MCbx/ictester-standalone/technical/testing_pcb.jpg

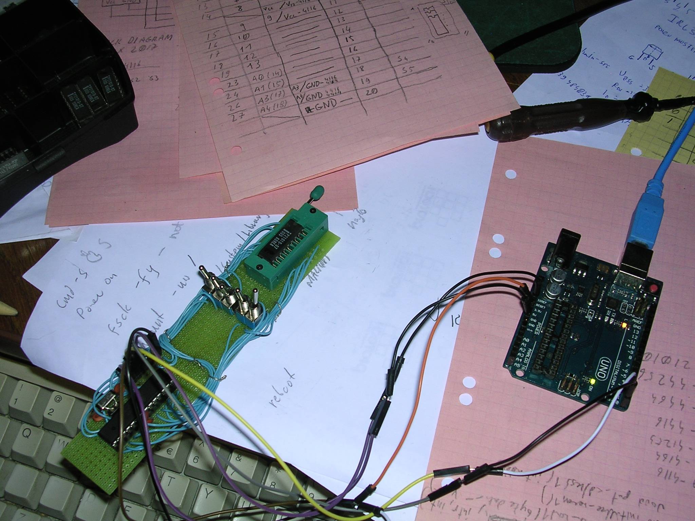
technical/testing_pcb.jpg
