MCbx/ictester-standalone/technical/prototype.jpg

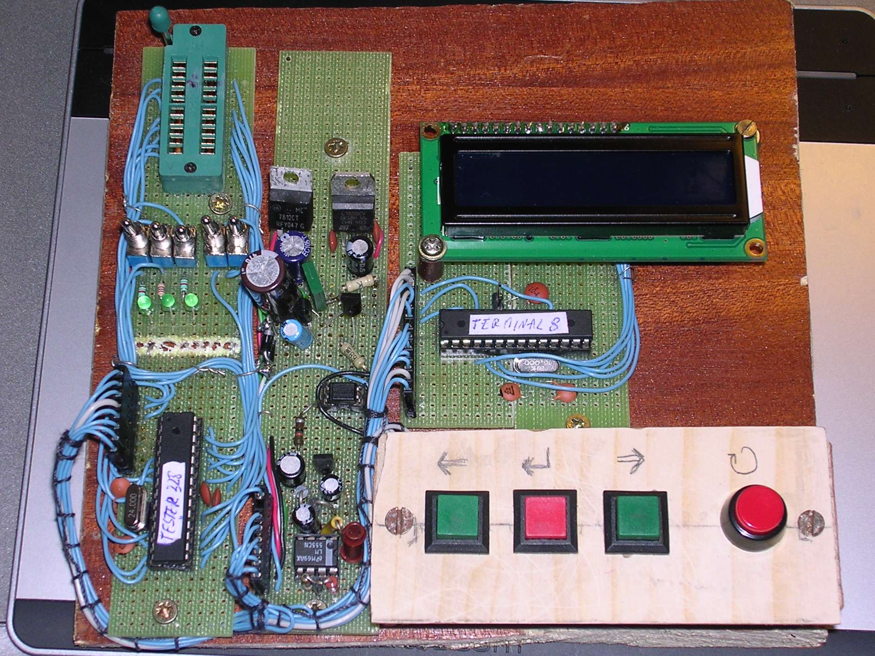
technical/prototype.jpg
