MCbx/ictester-standalone/technical/01_power_supply.jpg

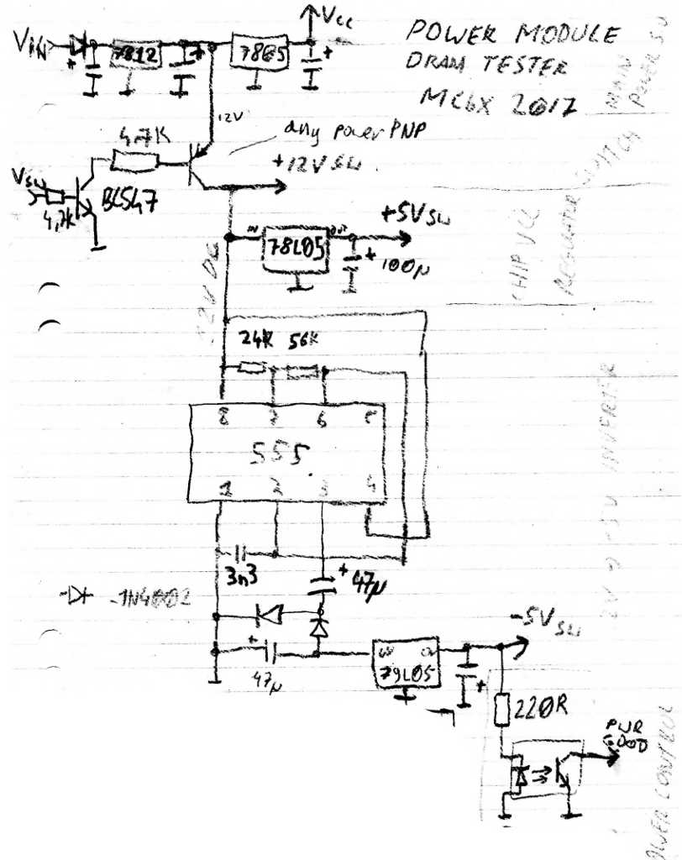
technical/01_power_supply.jpg
