MCbx/ictester-standalone/technical/03_dram_pins.jpg

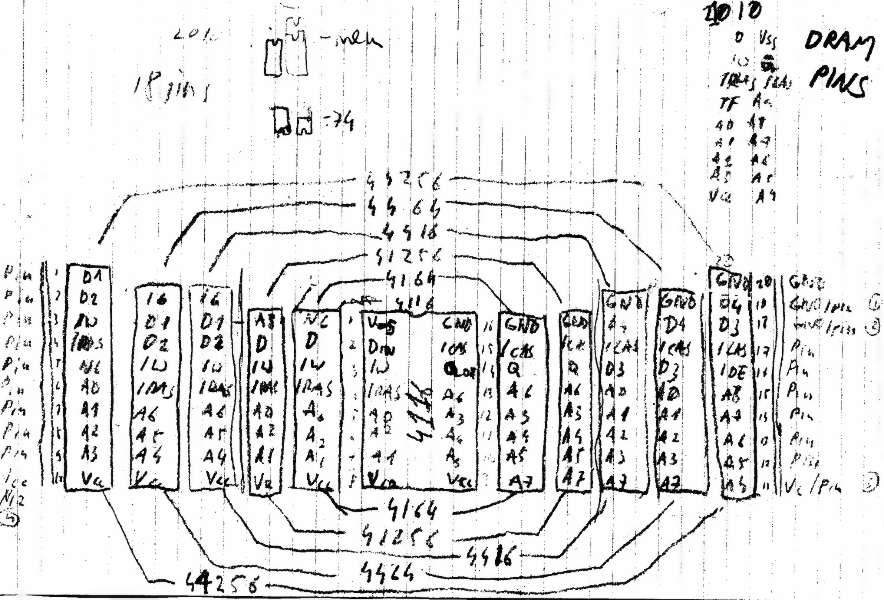
technical/03_dram_pins.jpg
