MCbx/ictester-standalone/technical/04_ttltest_chip_pins_vs_script_bits.jpg

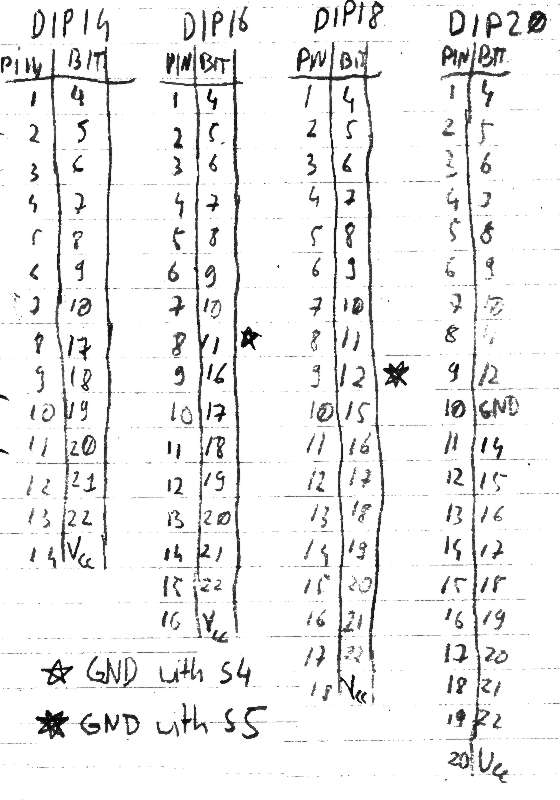
technical/04_ttltest_chip_pins_vs_script_bits.jpg
