MCbx/ictester-standalone/technical/prototype_modules_wiring.jpg

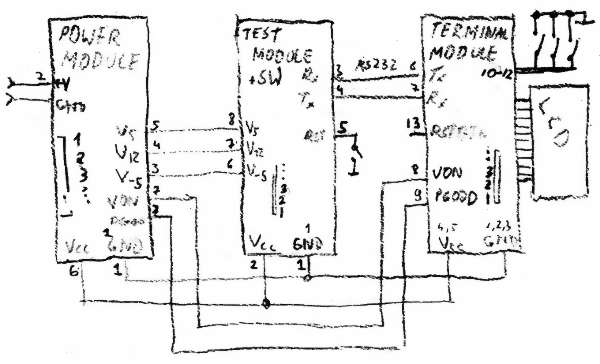
technical/prototype_modules_wiring.jpg
