MCbx/ictester-standalone/technical/02_tester_pins.jpg

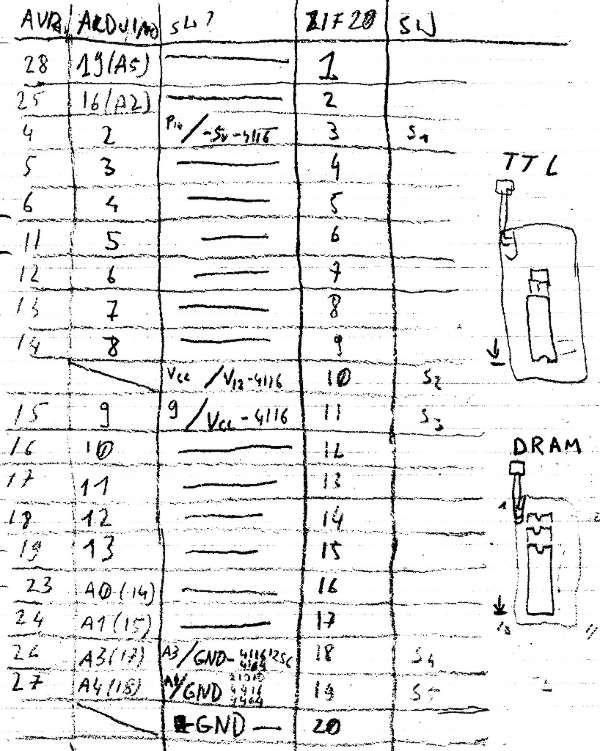
technical/02_tester_pins.jpg
