MCbx/ictester-standalone/main_tester/logic_test.ino

//TTL 74 tester
//EXPERIMENTAL
//MCbx 2017

//Please update me after writing script!
const PROGMEM unsigned long chips1[]={7400, 74000, 7401, 7402, 7403, 74040506, 7407, 740809, 7410, 7411, 7412, 7413, 7414, 7415, 7416, 
                                       7417, 7418, 7419, 7420, 7421, 7422, 7427, 7430, 7432, 7438, 7442, 7445, 7450, 7451, 7474,
                                       7485, 7486, 7495, 74125,74126,74132,74138,74139,74145,74147,74151,74153,74156,74161,74164,
                                       74165,74174,74175,74193,74240,74243,74244,74245,74251,74253,74257,74273,74299,74365,74373,
                                       74374,74393,74541,74027,8216, 8286, 74405,4011, 4012, 4013, 4015, 4016, 4024, 4027, 4040,
                                       4066, 4093, 40106};
#define chips1count 77   //me too!
 
//WRITING TEST SCRIPTS
//1. General order is the order of chips1.
//2. Script is array of longs. One long, one command. First 24 bits are used.
//3. First (0th) long is length of script with this number (eg. {3,22,33})
//4. Commands are following:
//  - 1xy - x - monitor for SW4, y - monitor for SW5 up. 3 for SW4, 5 for SW5, 7 for both
//  - 0000z - set i/o. 1 is input TO TESTER.
//  - 0001z - send states to ic
//  - 0011z - verify inputs against states
//  where z is always 20 bits of data. Rest is meaningless.
//5. After writing script, update const long* const script[] PROGMEM. Is must be this way or RAM will fill up.
// I'm giving a conv2script.pl Perl program to convert ICTester's MOD file to these numbers.

const long s001[] PROGMEM = {10,1180224, 8, 1180236, 4718888, 5899116, 2359448, 3539676, 7078328, 7078332};
const long s002[] PROGMEM = {12, 786944, 8, 786956, 1179720, 1179724, 2097288, 2359436, 4325640, 4325644, 7471560, 7471564};
const long s003[] PROGMEM = {10, 4718736, 8, 4718748, 2359880, 7078620, 1179944, 5898684, 3539816, 3539820};
const long s004[] PROGMEM = {10, 4718736, 8, 4718748, 1179944, 1179948, 2359880, 2359884, 3539816, 3539820};
const long s005[] PROGMEM = {10, 1180224, 8, 1180236, 4718888, 5899116, 2359448, 3539676, 7078328, 7078332};
const long s006[] PROGMEM = {6, 2753184, 8, 2753196, 5505368, 5505372};
const long s007[] PROGMEM = {6, 2753184, 8, 12, 5505368, 8258556};
const long s008[] PROGMEM = {10, 1180224, 8, 12, 5767528, 4718892, 2359448, 2359452, 7078328, 8258556};
const long s009[] PROGMEM = {18, 2228736, 8, 2228748, 262232, 2490972, 524456, 2753196, 786680, 3015420, 5243144, 7471884, 5505368, 7734108, 5767592, 7996332, 6029816, 6029820};
const long s010[] PROGMEM = {18, 2228736, 8, 12, 262232, 262236, 524456, 524460, 786680, 786684, 5243144, 5243148, 5505368, 5505372, 5767592, 5767596, 6029816, 8258556};
const long s011[] PROGMEM = {18, 2228736, 8, 2228748, 262232, 2490972, 524456, 2753196, 786680, 3015420, 5243144, 7471884, 5505368, 7734108, 5767592, 7996332, 6029816, 6029820};
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
const long s077[] PROGMEM = {10, 1573056, 8, 1573068, 2228504, 3801564, 4457000, 6030060, 6685496, 6685500};
const long s078[] PROGMEM = {6, 2753184, 8, 2753196, 8258552, 5505372};
//const long s061[] PROGMEM = {};

const long* const script[] PROGMEM = { s001, s002, s003, s004, s005, s006, s007, s008, s009, s010, s011, s012, s013, s014, s015,
                                       s016, s017, s018, s019, s020, s021, s022, s023, s024, s025, s026, s027, s028, s029, s030,
                                       s031, s032, s033, s034, s035, s036, s037, s038, s039, s040, s041, s042, s043, s044, s045,
                                       s046, s047, s048, s049, s050, s051, s052, s053, s054, s055, s056, s057, s058, s059, s060, 
                                       s061, s062, s063, s064, s065, s066, s067, s068, s069, s070, s071, s072, s073, s074, s075,
                                       s076, s077, s078};

const PROGMEM byte pins1[]={9,10,11,12,13,14,15,17,18,0,19,16,2,3,4,5,6,7,8,0};
byte menuptr1=0;
long prev_io=0;
unsigned int passNo=0;
unsigned int stepNo=0;

//void throw_err(int r, int c, int t, int p)

void BootTTLTester()
{
  powerOff();
  prev_io=0;
  passNo=0;
  stepNo=0;
 byte k='o';
  while (k!='s')
  {
    Serial.println("    74  TEST");
    Serial.print("   < ");
    Serial.print(pgm_read_dword_near(chips1+menuptr1));
    Serial.println(" >");
    while (Serial.available()==0);
    k=Serial.read();
    if (k=='a')
    {
        menuptr1--;
        if (menuptr1==255)
            menuptr1=chips1count-1;
    }
    if (k=='d') //forward
    {
        menuptr1++;
        if (menuptr1==chips1count)
            menuptr1=0;
    }
  }

  Serial.println(" RUNNING...");
  if (menuptr1==74)
  {
    powerOn();
    for (byte kk=0;kk<100;kk++)
    {
       test4040();
       passNo++;
    }
    powerOff();
  }

  else
  {
    run_script();
  }
  
  Serial.println(pgm_read_dword_near(chips1+menuptr1));  
  Serial.println("     OK!");
  while(1);
}

void run_script()
{
  powerOn();
  delay(1000); //wait 750ms for power to settle. 
              //a few hundres of ms is needed as we hack power here.
  long * ptr = (long*) pgm_read_word(&script[menuptr1]); //thisisagoodplacetostart
  for (byte i=0;i<100;i++) //repeat test 100 times
  {
    stepNo=0;
    for (long q=1;q<pgm_read_dword(&ptr[0]);q++)
    {
      stepNo++;
      parse_cmd(pgm_read_dword(&ptr[q]));
    }
    passNo++;
  }
  powerOff();
}

void parse_cmd(long a)
{
 // Serial.println(a);
 // return;
  if ((bitRead(a,0))&&(passNo==0)) //messages 111 - all sw up, 110 - sw4, 101 - sw5.
  {
    if (bitRead(a,1))
      Serial.println("SW4 UP");
    if (bitRead(a,2))
      Serial.println("SW5 UP");
    while (Serial.available()==0);
    Serial.println("RUNNING");
    return;
  }

  //0000 - set i/o. 1 - input TO TESTER.
  if ((!bitRead(a,3)) && (!bitRead(a,2)) && (!bitRead(a,1)))
  {
    prev_io=a;

    for (byte i=4;i<23;i++)
    {
      if (pgm_read_byte_near(pins1+i-4)==0)
        continue;
        
      if (bitRead(a,i)) pinMode(pgm_read_byte_near(pins1+i-4),INPUT_PULLUP);
        else
        {
          pinMode(pgm_read_byte_near(pins1+i-4),OUTPUT);
          digitalWrite(pgm_read_byte_near(pins1+i-4),LOW);
        }
        
    }
    return;  
  }

  //0001 - emit state
  if ((bitRead(a,3)) && (!bitRead(a,2)) && (!bitRead(a,1)))
  {

    for (byte i=4;i<23;i++)
    {
      if (pgm_read_byte_near(pins1+i-4)==0)
        continue;
        
      if ((bitRead(a,i))&&(!bitRead(prev_io,i))) digitalWrite(pgm_read_byte_near(pins1+i-4),HIGH);
      if ((!bitRead(a,i))&&(!bitRead(prev_io,i))) digitalWrite(pgm_read_byte_near(pins1+i-4),LOW);
    }
    return;  
  }

  //0011 - check state
  if ((bitRead(a,3)) && (bitRead(a,2)) && (!bitRead(a,1)))
  {
    for (byte i=4;i<23;i++)
    {
      if (pgm_read_byte_near(pins1+i-4)==0)
        continue;
        
      if ((bitRead(a,i)!=digitalRead(pgm_read_byte_near(pins1+i-4)))&&(bitRead(prev_io,i))) 
      {
        powerOff();
        Serial.println("");
        Serial.print("ERROR! PS");
        Serial.print(passNo);
        Serial.print(" ST");
        Serial.println(stepNo);
        Serial.print("SCKT PIN ");
        Serial.print(i-3);
        Serial.print(" IS ");
        Serial.print(digitalRead(pgm_read_byte_near(pins1+i-4)));
        while (Serial.available()==0);
        byte k=Serial.read();
        if (k=='a')
        {
          BootTTLTester();
        }
      }
    }
    
    return;  
  }
  
}

void err1(byte a)
{
  powerOff();
  Serial.print("ERROR! ");
  Serial.println(a);
  Serial.println("");
  while (1);
}

void test4040()
{
  if (passNo==0)
  {
    Serial.println("SW4 UP");
    while (Serial.available()==0);
  }
    pinMode(9,INPUT_PULLUP);  //1 Q11
    pinMode(10,INPUT_PULLUP); //2 Q5
    pinMode(11,INPUT_PULLUP); //3 Q4
    pinMode(12,INPUT_PULLUP); //4 Q6
    pinMode(13,INPUT_PULLUP);  //5 Q3
    pinMode(14,INPUT_PULLUP); //6 Q2
    pinMode(15,INPUT_PULLUP); //7 Q1, 8 is hardware GND
    
    pinMode(2,INPUT_PULLUP); //9 Q0
    pinMode(3,OUTPUT);        //10 - CLK
    pinMode(4,OUTPUT);       //11 - MR
    pinMode(5,INPUT_PULLUP); //12 Q8
    pinMode(6,INPUT_PULLUP);  //13 Q7
    pinMode(7,INPUT_PULLUP); //14 Q9
    pinMode(8,INPUT_PULLUP); //15 Q10, 16 is hardware Vcc.
    
    digitalWrite(3,LOW);
    digitalWrite(4,LOW);
    digitalWrite(4,HIGH);
    delay(2);
    digitalWrite(4,LOW);  //reset

    if ( (digitalRead(9))||(digitalRead(10))||(digitalRead(11))||(digitalRead(12))||(digitalRead(13))||(digitalRead(14))||(digitalRead(15))||
          (digitalRead(2))||(digitalRead(5))||(digitalRead(6))||(digitalRead(7))||(digitalRead(8)) )
    {
       err1(1);
    }

   digitalWrite(3,HIGH);
   digitalWrite(3,LOW);
   if ( (digitalRead(9))||(digitalRead(10))||(digitalRead(11))||(digitalRead(12))||(digitalRead(13))||(digitalRead(14))||(digitalRead(15))||
      (!digitalRead(2))||(digitalRead(5))||(digitalRead(6))||(digitalRead(7))||(digitalRead(8)) )
   {
     err1(2);
   }

  digitalWrite(3,HIGH);
  digitalWrite(3,LOW);
  if ( (digitalRead(9))||(digitalRead(10))||(digitalRead(11))||(digitalRead(12))||(digitalRead(13))||(digitalRead(14))||(!digitalRead(15))||
      (digitalRead(2))||(digitalRead(5))||(digitalRead(6))||(digitalRead(7))||(digitalRead(8)) )
   {
     err1(3);
   }

    for (int i=0;i<2;i++)
    {
      digitalWrite(3,HIGH);
      digitalWrite(3,LOW);
    }
   if ( (digitalRead(9))||(digitalRead(10))||(digitalRead(11))||(digitalRead(12))||(digitalRead(13))||(!digitalRead(14))||(digitalRead(15))||
      (digitalRead(2))||(digitalRead(5))||(digitalRead(6))||(digitalRead(7))||(digitalRead(8)) )
   {
     err1(4);
   }

    for (int i=0;i<4;i++)
    {
      digitalWrite(3,HIGH);
      digitalWrite(3,LOW);
    }
   if ( (digitalRead(9))||(digitalRead(10))||(digitalRead(11))||(digitalRead(12))||(!digitalRead(13))||(digitalRead(14))||(digitalRead(15))||
      (digitalRead(2))||(digitalRead(5))||(digitalRead(6))||(digitalRead(7))||(digitalRead(8)) )
   {
     err1(5);
   }

    for (int i=0;i<8;i++)
    {
      digitalWrite(3,HIGH);
      digitalWrite(3,LOW);
    }
    
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
   digitalWrite(4,LOW);
   
   if ( (digitalRead(9))||(digitalRead(10))||(digitalRead(11))||(digitalRead(12))||(digitalRead(13))||(digitalRead(14))||(digitalRead(15))||
      (digitalRead(2))||(digitalRead(5))||(digitalRead(6))||(digitalRead(7))||(digitalRead(8)) )
   {
     err1(14);
   } 
}
